kumamuk-git/roBa/pcb/EVQWGD001_extension/EVQWGD001_extension.kicad_pcb

## KiCad design pcb/EVQWGD001_extension/EVQWGD001_extension.kicad_pcb (2024-09-16)

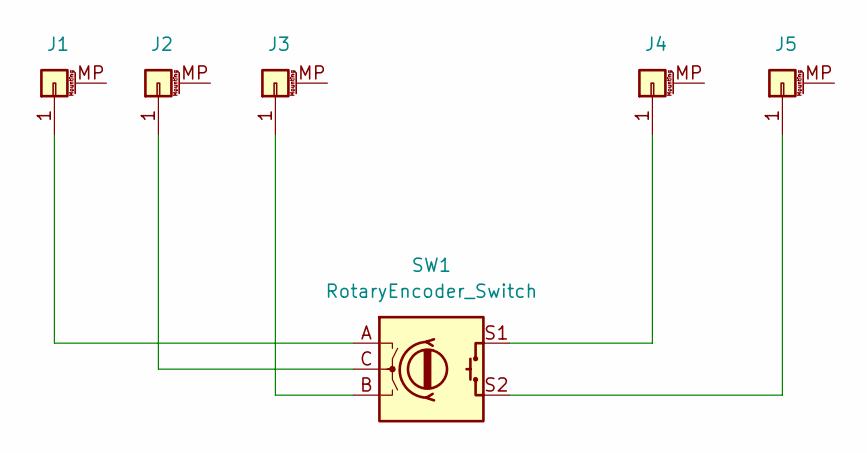
[picture p3: schematic EVQWGD001_extension.kicad_sch]

Parts:
J1, J2, J3, J4, J5: Conn_01x01_MountingPin; PinSocket_1x01_P2.54mm_Vertical
SW1: RotaryEncoder_Switch; EVQWGD001

Connections:
unnamed: J1.1, SW1.A
unnamed: J2.1, SW1.C
unnamed: J3.1, SW1.B
unnamed: J4.1, SW1.S1
unnamed: J5.1, SW1.S2

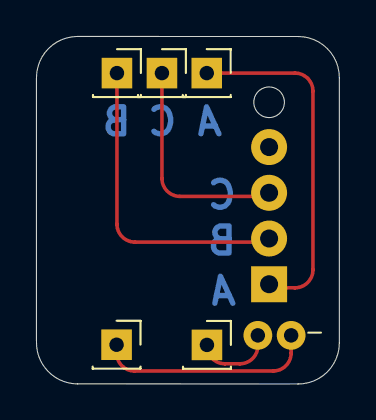
[picture p4: board EVQWGD001_extension.kicad_pcb from above]

Board: 2 copper layers, 16.8 x 19.3 mm, 6 parts (0 on the bottom side), 5 nets.
