kumamuk-git/roBa/pcb/pmw3610_breakout_for_roBa/pmw3610_breakout_for_roBa.kicad_pcb

## KiCad design pcb/pmw3610_breakout_for_roBa/pmw3610_breakout_for_roBa.kicad_pcb (2024-09-16)

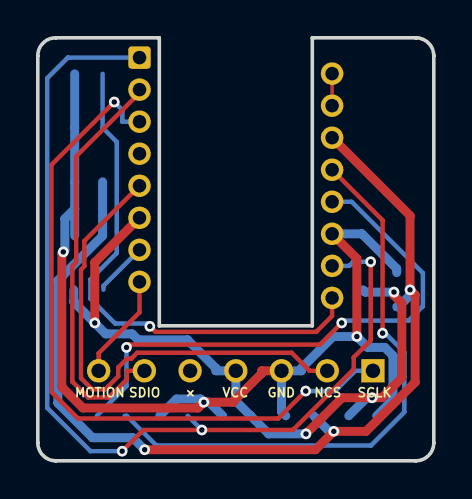
[picture p5: board pmw3610_breakout_for_roBa.kicad_pcb from above]

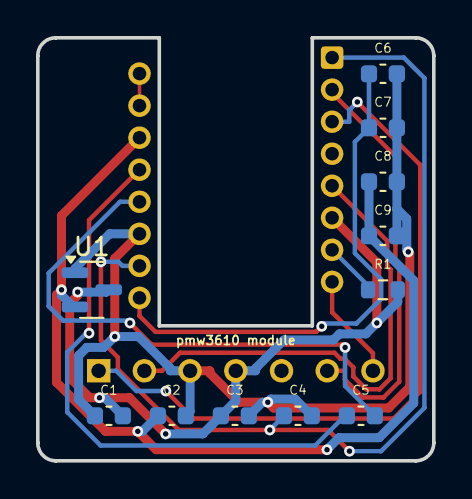
[picture p6: board pmw3610_breakout_for_roBa.kicad_pcb from below]

Board: 2 copper layers, 22.0 x 23.5 mm, 13 parts (11 on the bottom side), 13 nets.

Parts:
C1, C2: 1u; C_0603_1608Metric
C3, C8: 100n; C_0603_1608Metric
C4: 10n; C_0603_1608Metric
C5: 100n (X7R); C_0603_1608Metric
C6: 10u (X7R); C_0603_1608Metric
C7: 10n (X7R); C_0603_1608Metric
C9: 3.3u/25V; C_0603_1608Metric
J1: Conn_01x08; pmw3610_connector_b
R1: 2M; R_0603_1608Metric
U1: MCP1700T-1802E/TT; SOT-23
U2: PMW3610; PMW3610DM-SUDU 16Pin

Connections:
+1V9: C2.1, C8.1, C9.1, U1.2 (VO), U2.14 (VDD)
GND: C1.1, C2.2, C3.2, C4.2, C6.2, C7.2, C8.2, C9.2, J1.3, U1.1 (GND), U2.11 (GND)
MOTION: J1.7 (Pin_6), U2.8 (MOTION)
NCS: J1.2, U2.5 (NCS)
unnamed: C4.1, U2.1 (+VCSEL), U2.10 (PASS_T)
unnamed: U2.15 (XYLASER), U2.16 (-VCSEL)
unnamed: C5.1, U2.13 (CN)
unnamed: C5.2, U2.12 (CP)
unnamed: R1.1, U2.7 (NRESET)
unnamed: C6.1, C7.1, U2.9 (VCP)
SCLK: J1.1, U2.3 (SCLK)
SDIO: J1.6, U2.2 (SDIO)
VCC: C1.2, C3.1, J1.4, R1.2, U1.3 (VI), U2.6 (VDDIO)
